harnettlab/Shape-Sensor-Demo/Documentation/DemoScreenshot.png

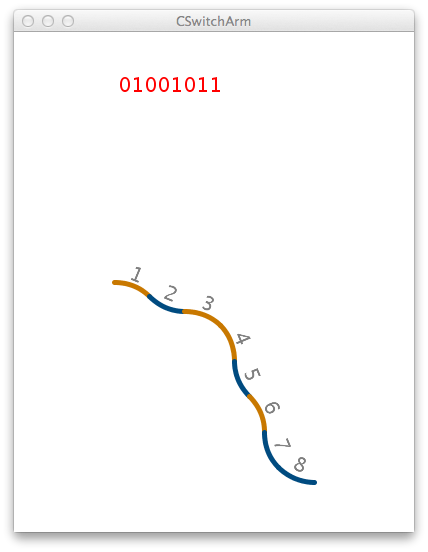
Documentation/DemoScreenshot.png
