harnettlab/Shape-Sensor-Demo/MechanicalLayout/DelrinLayout.pdf

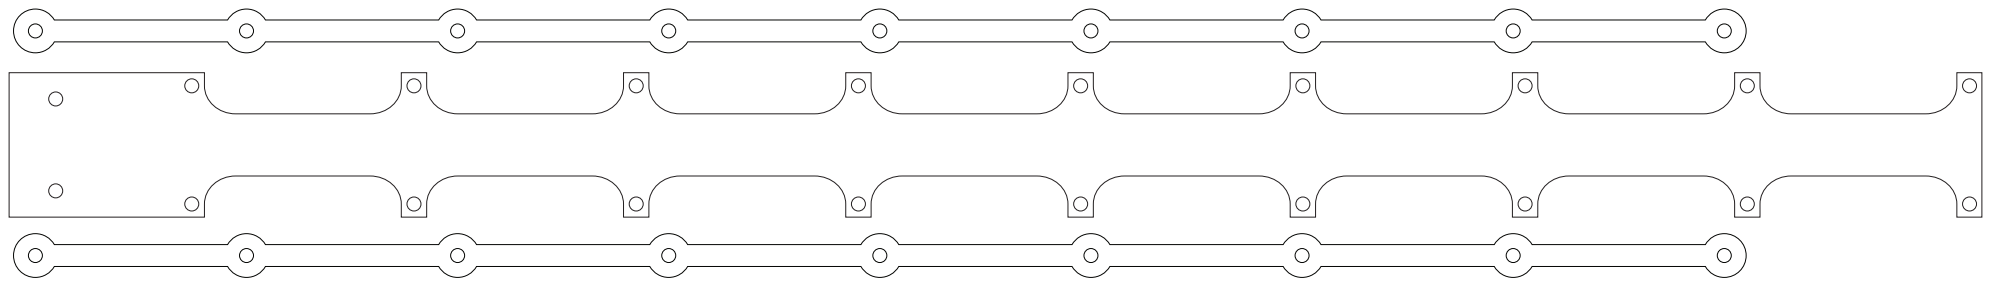
[picture p2: page 1]
