harnettlab/Shape-Sensor-Demo/PCB/PortExpanderCircuit.brd

## EAGLE design PCB/PortExpanderCircuit.brd (2013-05-16)

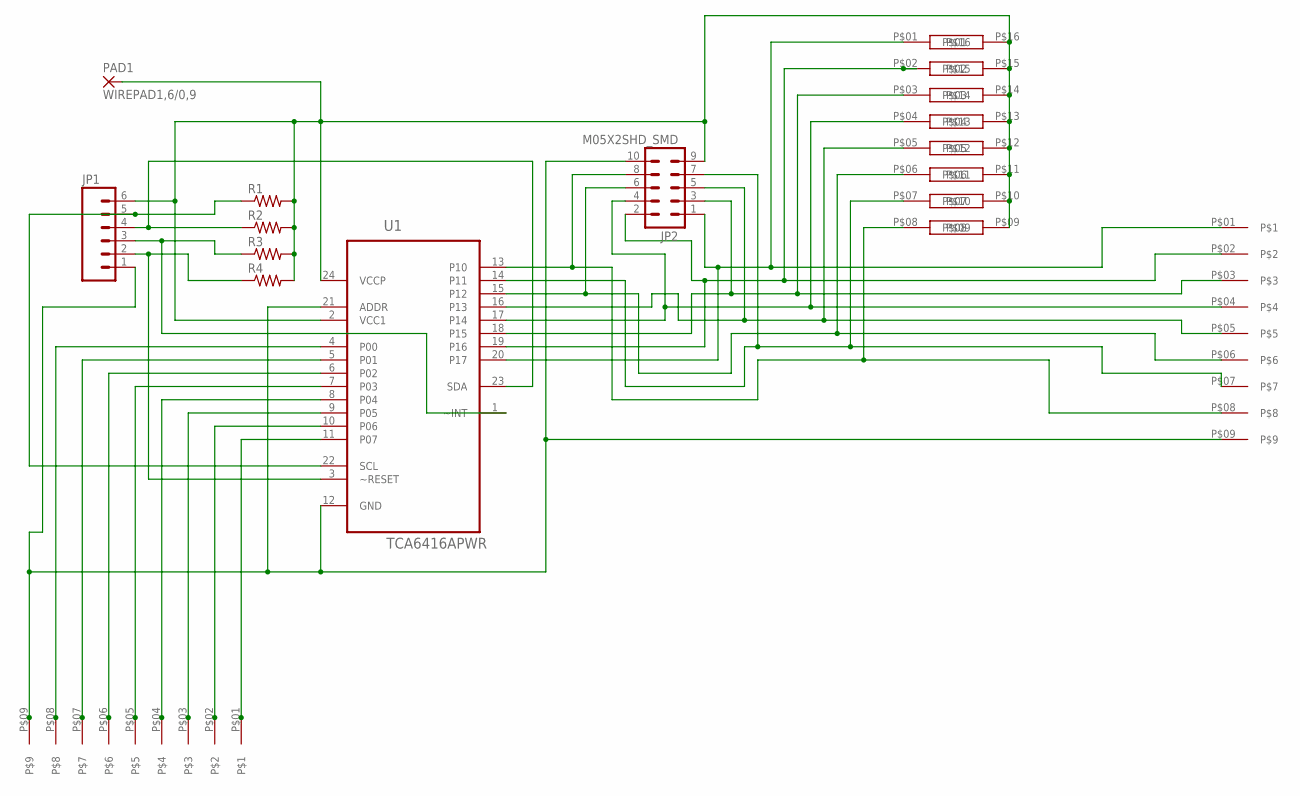
[picture p3: schematic PortExpanderCircuit.sch]

Parts:
JP1: M06LOCK_LONGPADS; 1X06_LOCK_LONGPADS
JP2: M05X2SHD_SMD; 2X5-SHROUDED_SMD
PAD1: WIREPAD1,6/0,9; 1,6/0,9
R1, R2, R3, R4: RESISTOR0805-RES; 0805
U1: TCA6416APWR; SOP65P640X120-24N
U$1, U$2: TECONN_FPC_FFC_84953-9; TECONN_84953-9
U$3: EXB-A10P_8_RESISTOR_ARRAY; EXB-A10P

Connections:
unnamed: JP1.1, JP2.10, U1.12 (GND), U1.21 (ADDR), U$1.P$09, U$2.P$09
unnamed: JP2.8, U1.13 (P10), U$1.P$08, U$3.P$08
unnamed: JP2.7, U1.14 (P11), U$1.P$07, U$3.P$07
unnamed: JP2.6, U1.15 (P12), U$1.P$06, U$3.P$06
unnamed: JP2.5, U1.16 (P13), U$1.P$05, U$3.P$05
unnamed: JP2.4, U1.17 (P14), U$1.P$04, U$3.P$04
unnamed: JP2.3, U1.18 (P15), U$1.P$03, U$3.P$03
unnamed: JP2.2, U1.19 (P16), U$1.P$02, U$3.P$02
unnamed: JP2.1, U1.20 (P17), U$1.P$01, U$3.P$01
unnamed: U1.4 (P00), U$2.P$08
unnamed: U1.5 (P01), U$2.P$07
unnamed: U1.6 (P02), U$2.P$06
unnamed: U1.7 (P03), U$2.P$05
unnamed: U1.8 (P04), U$2.P$04
unnamed: U1.9 (P05), U$2.P$03
unnamed: U1.10 (P06), U$2.P$02
unnamed: U1.11 (P07), U$2.P$01
unnamed: JP1.5, R1.1, U1.22 (SCL)
unnamed: JP1.4, R2.1, U1.23 (SDA)
unnamed: JP1.3, R3.1, U1.1 (~INT)
unnamed: JP1.6, JP2.9, PAD1.1, R1.2, R2.2, R3.2, R4.2, U1.2 (VCC1), U1.24 (VCCP), U$3.P$09, U$3.P$10, U$3.P$11, U$3.P$12, U$3.P$13, U$3.P$14, U$3.P$15, U$3.P$16
unnamed: JP1.2, R4.1, U1.3 (~RESET)

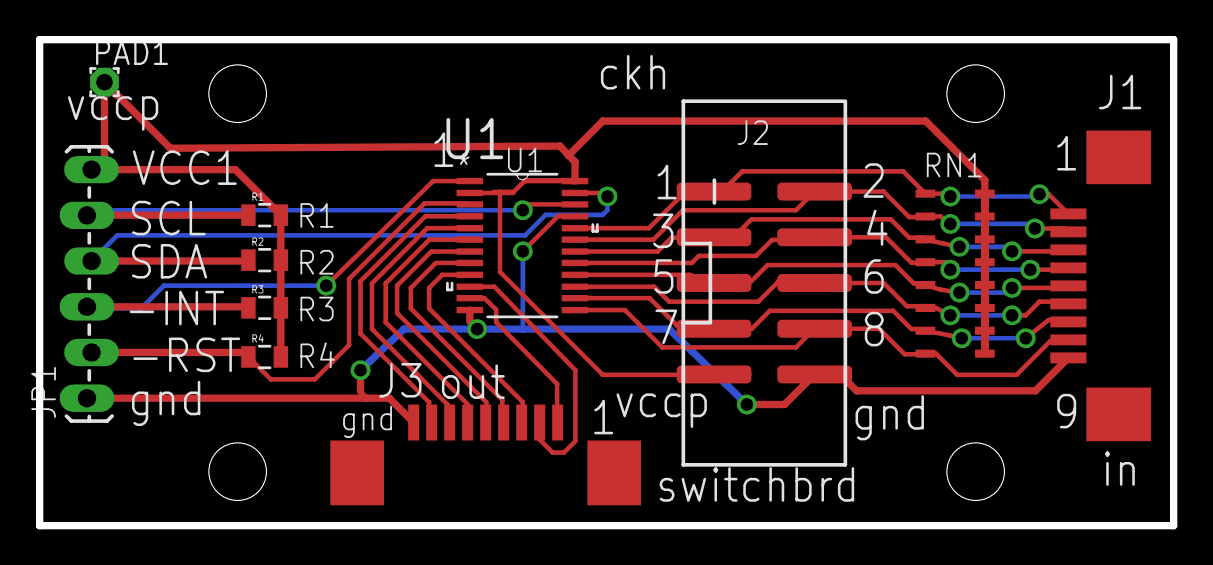
[picture p4: board PortExpanderCircuit.brd from above]

Board: 2 copper layers, 63.0 x 27.0 mm, 11 parts (0 on the bottom side), 22 nets.
